lab11/polypoint/pcb/tripoint/v2p0/protopoint.kicad_pcb

## KiCad design pcb/tripoint/v2p0/protopoint.kicad_pcb (2016-08-17)

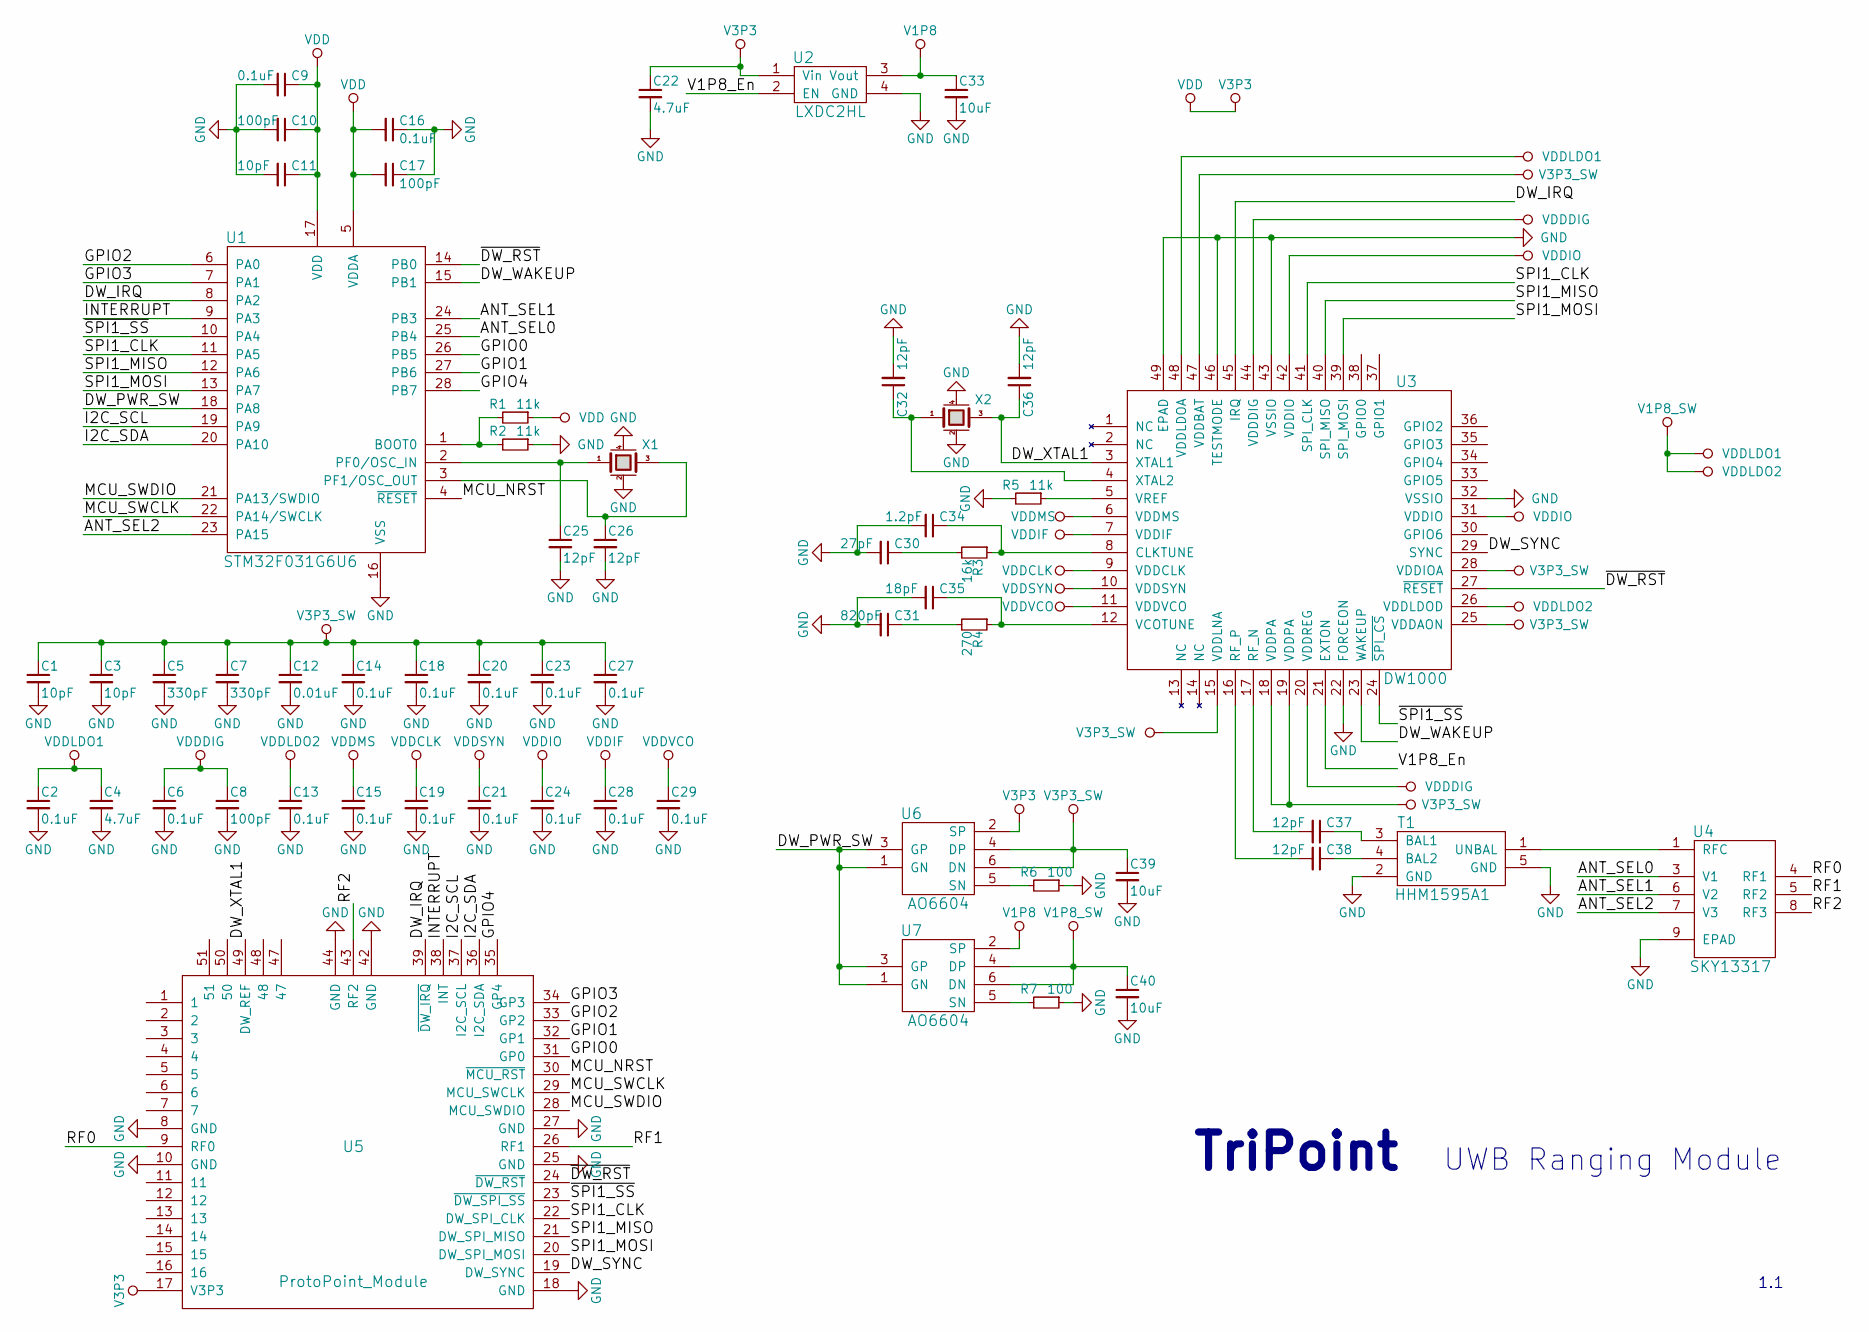
[picture p1: schematic protopoint.sch]

Parts:
C1, C3, C11: 10pF; C_0201; ManPartNo GRM0335C1E100JA01D
C2, C6, C9, C13, C14, C15, C16, C18, C19, C20, C21, C23, C24, C27, C28, C29: 0.1uF; C_0201; ManPartNo GRM033R61A104KE15D
C4, C22: 4.7uF; C_0603; ManPartNo GRM188F51A475ZE20D
C5, C7: 330pF; C_0201; ManPartNo GRM033R71E331KA01D
C8, C10, C17: 100pF; C_0201; ManPartNo GRM0335C1E101JA01D
C12: 0.01uF; C_0201; ManPartNo GRM033R71A103KA01D
C25, C26, C32, C36: 12pF; C_0201; ManPartNo GRM0335C1E120JA01D
C30: 27pF; C_0201; ManPartNo GRM0335C1E270JA01D
C31: 820pF; C_0201; ManPartNo GRM033R71E821KA01D
C33, C39, C40: 10uF; C_0603; ManPartNo GRM188R61C106MA73D
C34: 1.2pF; C_0201; ManPartNo GRM0335C1H1R2CA01D
C35: 18pF; C_0201; ManPartNo GRM0335C1H180JA01D
C37, C38: 12pF; C_0402; ManPartNo GRM1555C1H120JA01D
R1, R2, R5: 11k; R_0201; ManPartNo ERJ-1GEF1102C
R3: 16k; R_0201; ManPartNo ERJ-1GEF1602C
R4: 270; R_0201; ManPartNo ERJ-1GEF2700C
R6, R7: 100; R_0201; ManPartNo ERJ-1GEF1102C
T1: HHM1595A1; ManPartNo HHM1595A1
U1: STM32F031G6U6; UFQFPN-28; ManPartNo STM32F031G6U6
U2: LXDC2HL; ManPartNo LXDC2HL18A-052
U3: DW1000; QFN-48-EP-6x6mm; ManPartNo DW1000-I-TR13
U4: SKY13317; MLPQ-UT-8-1.5X1.5mm; ManPartNo SKY13317-373LF
U5: ProtoPoint_Module; ProtoPoint_Module_Castellated
U6, U7: AO6604; TSOP-6
X1: 38.4M; FA-128; ManPartNo FA-20H 38.4000MF10Z-AS3
X2: 16M; FA-128; ManPartNo FA-20H 16.0000MF10Z-AJ3

Connections:
/ANT_SEL0: U1.25 (PB4), U4.3 (V1)
/ANT_SEL1: U1.24 (PB3), U4.6 (V2)
/ANT_SEL2: U1.23 (PA15), U4.7 (V3)
/DW_IRQ: U1.8 (PA2), U3.45 (IRQ), U5.39 (~DW_IRQ)
/DW_PWR_SW: U1.18 (PA8), U6.1 (GN), U6.3 (GP), U7.1 (GN), U7.3 (GP)
/DW_SYNC: U3.29 (SYNC), U5.19 (DW_SYNC)
/DW_WAKEUP: U1.15 (PB1), U3.23 (WAKEUP)
/DW_XTAL1: C36.1, U3.3 (XTAL1), U5.49 (DW_REF), X2.3
/GPIO0: U1.26 (PB5), U5.31 (GP0)
/GPIO1: U1.27 (PB6), U5.32 (GP1)
/GPIO2: U1.6 (PA0), U5.33 (GP2)
/GPIO3: U1.7 (PA1), U5.34 (GP3)
/GPIO4: U1.28 (PB7), U5.35 (GP4)
/I2C_SCL: U1.19 (PA9), U5.37 (I2C_SCL)
/I2C_SDA: U1.20 (PA10), U5.36 (I2C_SDA)
/INTERRUPT: U1.9 (PA3), U5.38 (INT)
/MCU_NRST: U1.4 (~RESET), U5.30 (~MCU_RST)
/MCU_SWCLK: U1.22 (PA14/SWCLK), U5.29 (MCU_SWCLK)
/MCU_SWDIO: U1.21 (PA13/SWDIO), U5.28 (MCU_SWDIO)
/RF0: U4.4 (RF1), U5.9 (RF0)
/RF1: U4.5 (RF2), U5.26 (RF1)
/RF2: U4.8 (RF3), U5.43 (RF2)
/SPI1_CLK: U1.11 (PA5), U3.41 (SPI_CLK), U5.22 (DW_SPI_CLK)
/SPI1_MISO: U1.12 (PA6), U3.40 (SPI_MISO), U5.21 (DW_SPI_MISO)
/SPI1_MOSI: U1.13 (PA7), U3.39 (SPI_MOSI), U5.20 (DW_SPI_MOSI)
/V1P8_En: U2.2 (EN), U3.21 (EXTON)
/~DW_RST: U1.14 (PB0), U3.27 (~RESET), U5.24 (~DW_RST)
/~SPI1_SS: U1.10 (PA4), U3.24 (~SPI_CS), U5.23 (~DW_SPI_SS)
GND: C1.2, C2.2, C3.2, C4.2, C5.2, C6.2, C7.2, C8.2, C9.2, C10.2, C11.2, C12.2, C13.2, C14.2, C15.2, C16.1, C17.1, C18.2, C19.2, C20.2, C21.2, C22.2, C23.2, C24.2, C25.2, C26.2, C27.2, C28.2, C29.2, C30.2, C31.2, C32.2, C33.2, C34.2, C35.2, C36.2, C39.2, C40.2, R2.1, R5.2, R6.1, R7.1, T1.2 (GND), T1.5 (GND), U1.16 (VSS), U2.4 (GND), U3.22 (FORCEON), U3.32 (VSSIO), U3.43 (VSSIO), U3.46 (TESTMODE), U3.49 (EPAD), U4.9 (EPAD), U5.8 (GND), U5.10 (GND), U5.18 (GND), U5.25 (GND), U5.27 (GND), U5.42 (GND), U5.44 (GND), X1.2 (case), X1.4, X2.2 (case), X2.4
unnamed: C25.1, U1.2 (PF0/OSC_IN), X1.1
unnamed: C26.1, U1.3 (PF1/OSC_OUT), X1.3
unnamed: C30.1, R3.2
unnamed: C31.1, R4.2
unnamed: C32.1, U3.4 (XTAL2), X2.1
unnamed: C34.1, R3.1, U3.8 (CLKTUNE)
unnamed: C35.1, R4.1, U3.12 (VCOTUNE)
unnamed: C37.1, T1.3 (BAL1)
unnamed: C37.2, U3.17 (RF_N)
unnamed: C38.1, T1.4 (BAL2)
unnamed: C38.2, U3.16 (RF_P)
unnamed: R1.2, R2.2, U1.1 (BOOT0)
unnamed: R5.1, U3.5 (VREF)
unnamed: R6.2, U6.5 (SN)
unnamed: R7.2, U7.5 (SN)
unnamed: T1.1 (UNBAL), U4.1 (RFC)
V1P8: C33.1, U2.3 (Vout), U7.2 (SP)
V1P8_SW: C2.1, C4.1, C13.1, C40.1, U3.26 (VDDLDOD), U3.48 (VDDLDOA), U7.4 (DP), U7.6 (DN)
V3P3: C9.1, C10.1, C11.1, C16.2, C17.2, C22.1, R1.1, U1.5 (VDDA), U1.17 (VDD), U2.1 (Vin), U5.17 (V3P3), U6.2 (SP)
V3P3_SW: C1.1, C3.1, C5.1, C7.1, C12.1, C14.1, C18.1, C20.1, C23.1, C27.1, C39.1, U3.15 (VDDLNA), U3.18 (VDDPA), U3.19 (VDDPA), U3.25 (VDDAON), U3.28 (VDDIOA), U3.47 (VDDBAT), U6.4 (DP), U6.6 (DN)
VDDCLK: C19.1, U3.9 (VDDCLK)
VDDDIG: C6.1, C8.1, U3.20 (VDDREG), U3.44 (VDDDIG)
VDDIF: C28.1, U3.7 (VDDIF)
VDDIO: C24.1, U3.31 (VDDIO), U3.42 (VDDIO)
VDDMS: C15.1, U3.6 (VDDMS)
VDDSYN: C21.1, U3.10 (VDDSYN)
VDDVCO: C29.1, U3.11 (VDDVCO)

Notes on the sheet:
TriPoint
1.1
UWB Ranging Module

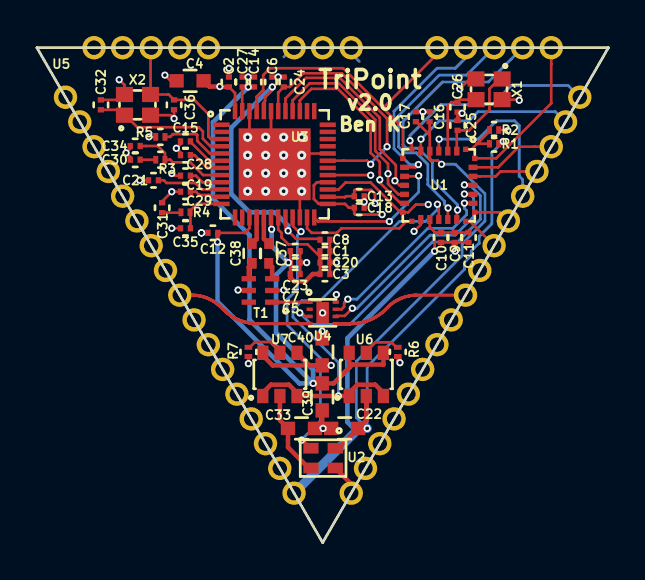
[picture p2: board protopoint.kicad_pcb from above]

Board: 4 copper layers, 31.8 x 27.5 mm, 57 parts (0 on the bottom side), 56 nets.
