lab11/polypoint/pcb/pinpoint/pinpoint_timebase/pinpoint_timebase.kicad_pcb

## KiCad design pcb/pinpoint/pinpoint_timebase/pinpoint_timebase.kicad_pcb (2016-02-21)

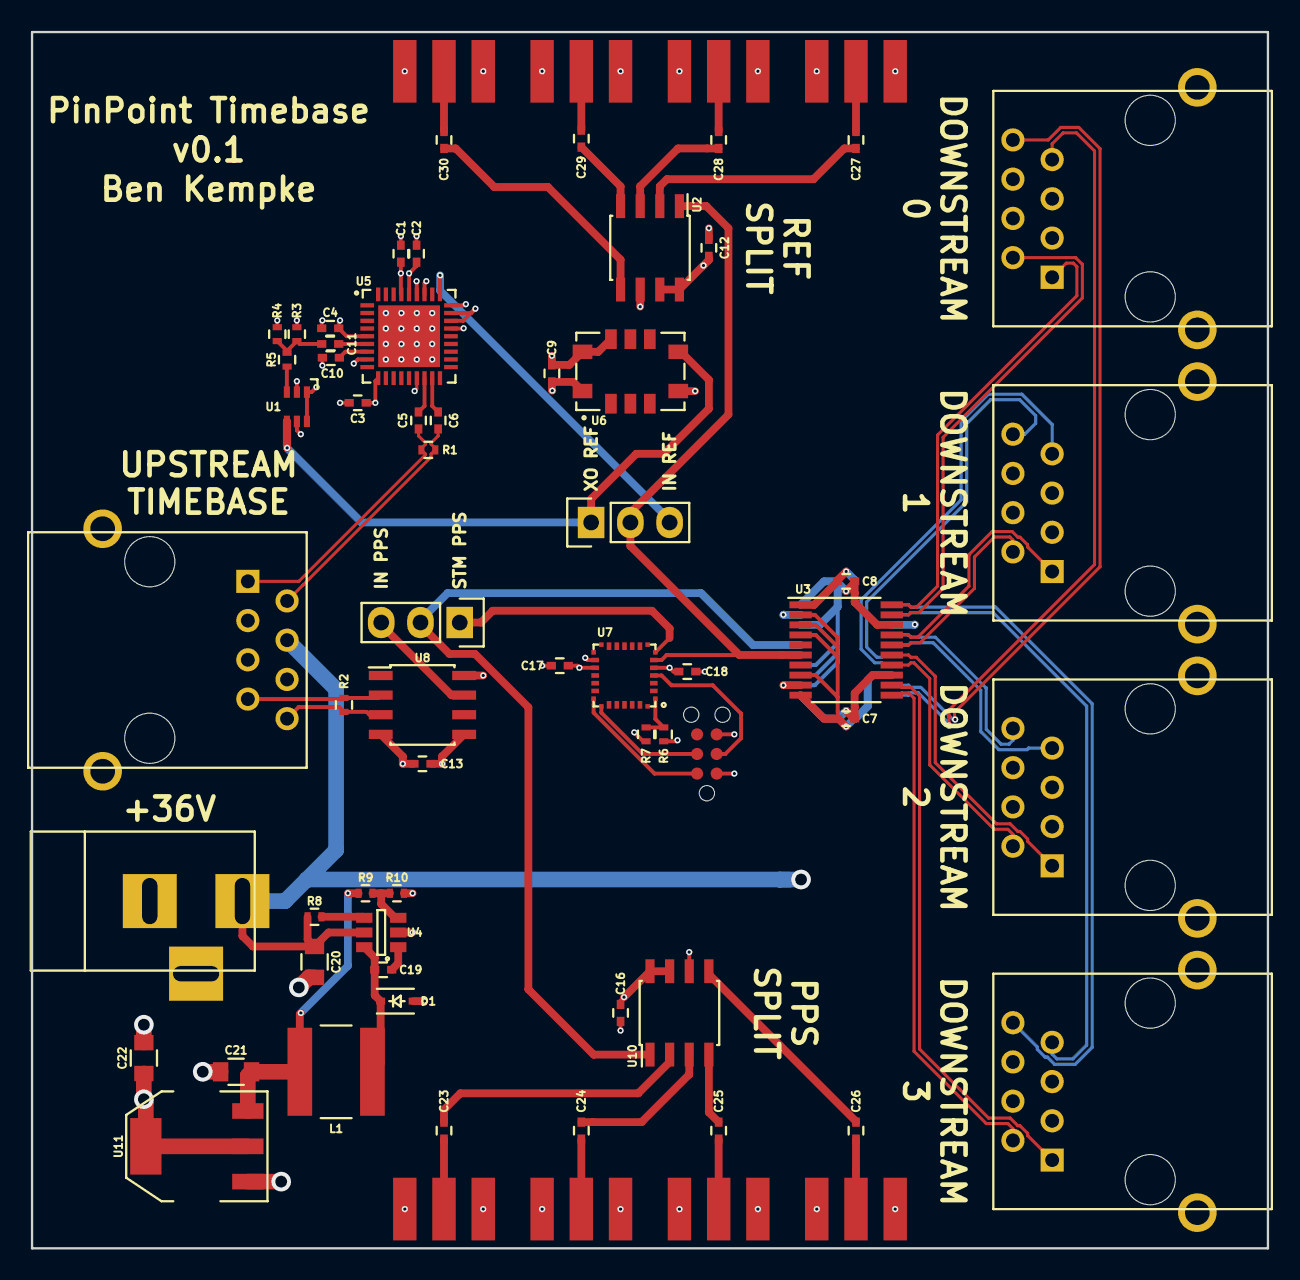
[picture p3: board pinpoint_timebase.kicad_pcb from above]

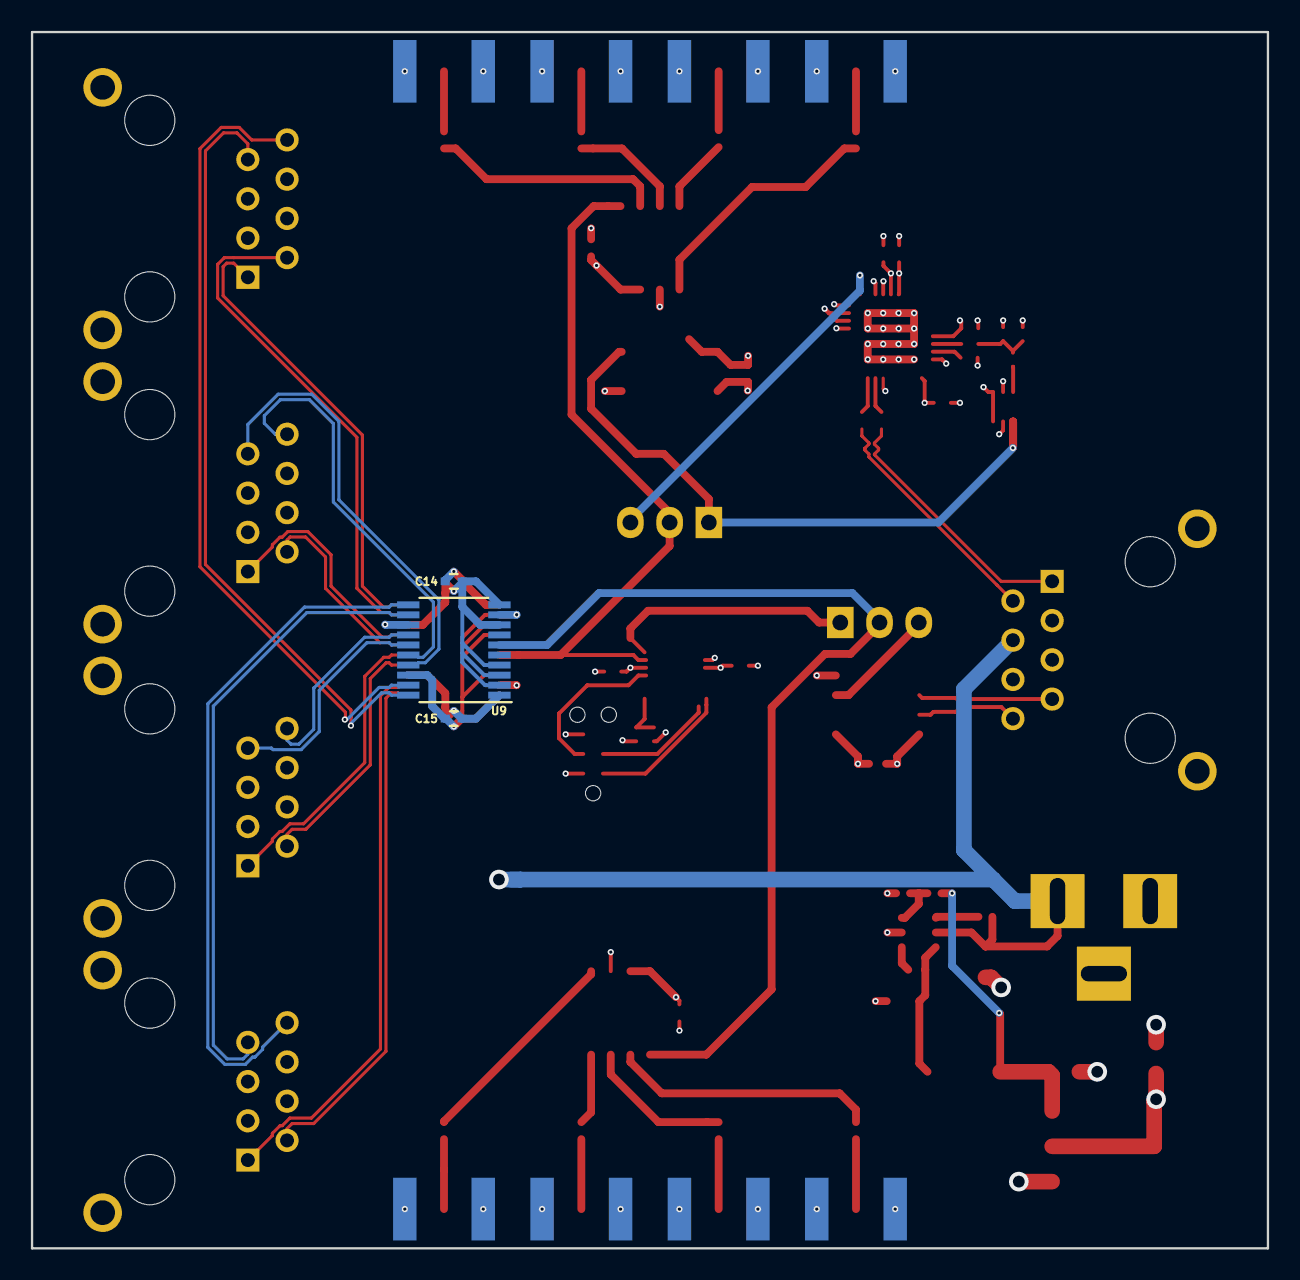
[picture p4: board pinpoint_timebase.kicad_pcb from below]

Board: 4 copper layers, 80.0 x 78.7 mm, 70 parts (3 on the bottom side), 60 nets.

Parts:
C1, C2, C3, C4, C5, C6, C7, C8, C9, C10, C11, C12, C13, C14, C15, C16, C17, C18, C19, C23, C24, C25, C26, C27, C28, C29, C30: 0.1uF; C_0402
C20: 4.7uF; C_0805
C21, C22: 10uF; C_0805
CON1: BARREL_JACK
D1: D_Schottky; SOD-323
J1, J2, J3, J4, J5: RJ45; RJ45_8
J6: TC2030-JLINK-NL; TC2030
L1: 22uH; NR6045
P1, P6: CONN_01X03; Pin_Header_Straight_1x03
P2, P3, P4, P5, P8, P9, P10: SMA; SMA_EDGE
R1, R2, R6, R7: R_Small; R_0402
R3, R4: 150; R_0402
R5: 130; R_0402
R8: 4.7K; R_0402
R9: 49.9K; R_0402
R10: 9.53K; R_0402
U1: SN74AVC1T45; SC-70-6
U2, U10: 551S; SOIC-8_3.9x4.9mm_Pitch1.27mm
U3, U9: ICS8545; TSSOP-20_4.4x6.5mm_Pitch0.65mm
U4: AOZ1282CI; SOT-23-6
U5: SI5317; QFN-36_1EP_6x6mm
U6: 7N-XX.XXXMBP-T; 7N-xx.xxxMBP-T
U7: STM32F031G4U6; UFQFPN-28
U8: 830S21; SOIC-8_3.9x4.9mm_Pitch1.27mm
U11: NCP1117; SOT-223
eP7: SMA; SMA_EDGE

Connections:
/CLK0+: J3.1, U3.20
/CLK0-: J3.2, U3.19
/CLK1+: J4.1, U3.17
/CLK1-: J4.2, U3.16
/CLK2+: J1.1, U3.15
/CLK2-: J1.2, U3.14
/CLK3+: J5.1, U3.12
/CLK3-: J5.2, U3.11
/IN_PPS+: J2.7, R2.1, U8.2
/IN_PPS-: J2.8, R2.2, U8.3
/IN_REF+: C5.2, J2.1, R1.1
/IN_REF-: C6.2, J2.2, R1.2
/PPS0+: J3.7, U9.20
/PPS0-: J3.8, U9.19
/PPS1+: J4.7, U9.17
/PPS1-: J4.8, U9.16
/PPS2+: J1.7, U9.15
/PPS2-: J1.8, U9.14
/PPS3+: J5.7, U9.12
/PPS3-: J5.8, U9.11
/REFTMP+: C5.1, U5.16
/REFTMP-: C6.1, U5.17
/SYS_CLK: P1.2, U2.1, U3.6, U7.6
GND: C1.2, C2.1, C3.2, C4.1, C7.2, C8.1, C9.2, C10.1, C12.2, C13.2, C14.2, C15.1, C16.2, C17.2, C18.1, C20.2, C21.2, C22.2, CON1.2, CON1.3, D1.2, J1.5, J1.9, J2.5, J2.9, J3.5, J3.9, J4.5, J4.9, J5.5, J5.9, J6.5, P2.2, P3.2, P4.2, P5.2, P8.2, P9.2, P10.2, R4.1, R7.2, R10.2, U1.2, U1.5, U2.6, U3.1, U3.9, U3.13, U4.2, U5.8, U5.15, U5.24, U5.27, U5.30, U5.31, U5.37, U6.4, U6.10, U7.16, U8.5, U9.1, U9.9, U9.13, U10.6, U11.1, eP7.2
unnamed: C10.2, U5.7
unnamed: C11.1, R3.1, R4.2, R5.2
unnamed: C11.2, U5.6
unnamed: C19.1, D1.1, L1.1, U4.6
unnamed: C19.2, U4.1
unnamed: C21.1, L1.2, R9.1, U11.3
unnamed: C23.1, U10.2
unnamed: C23.2, eP7.1
unnamed: C24.1, U10.3
unnamed: C24.2, P8.1
unnamed: C25.1, U10.4
unnamed: C25.2, P9.1
unnamed: C26.1, U10.5
unnamed: C26.2, P10.1
unnamed: C27.1, U2.2
unnamed: C27.2, P2.1
unnamed: C28.1, U2.3
unnamed: C28.2, P3.1
unnamed: C29.1, U2.4
unnamed: C29.2, P4.1
unnamed: C30.1, U2.5
unnamed: C30.2, P5.1
unnamed: J6.2, U7.21
unnamed: J6.3, U7.4
unnamed: J6.4, U7.22
unnamed: P1.1, U1.4, U6.5
unnamed: P1.3, U5.28
unnamed: P6.1, U7.7
unnamed: P6.2, U9.6, U10.1
unnamed: P6.3, U8.7
unnamed: R5.1, U1.3
unnamed: R6.1, R7.1, U7.1
unnamed: R8.2, U4.4
unnamed: R9.2, R10.1, U4.3
V3P3: C1.1, C2.2, C3.1, C4.2, C7.1, C8.2, C9.1, C12.1, C13.1, C14.1, C15.2, C16.1, C17.1, C18.2, C22.1, J6.1, R3.2, R6.2, U1.1, U1.6, U2.7, U2.8, U3.2, U3.3, U3.4, U3.8, U3.10, U3.18, U5.5, U5.10, U5.25, U5.26, U5.32, U5.33, U6.8, U6.9, U7.5, U7.17, U8.4, U8.8, U9.2, U9.3, U9.4, U9.8, U9.10, U9.18, U10.7, U10.8, U11.2, U11.4
VDD: C20.1, CON1.1, J1.4, J2.4, J3.4, J4.4, J5.4, R8.1, U4.5
