lab11/polypoint/pcb/pinpoint/pinpoint_tridev_adapter/pinpoint_tridev_adapter.kicad_pcb

## KiCad design pcb/pinpoint/pinpoint_tridev_adapter/pinpoint_tridev_adapter.kicad_pcb (2016-02-21)

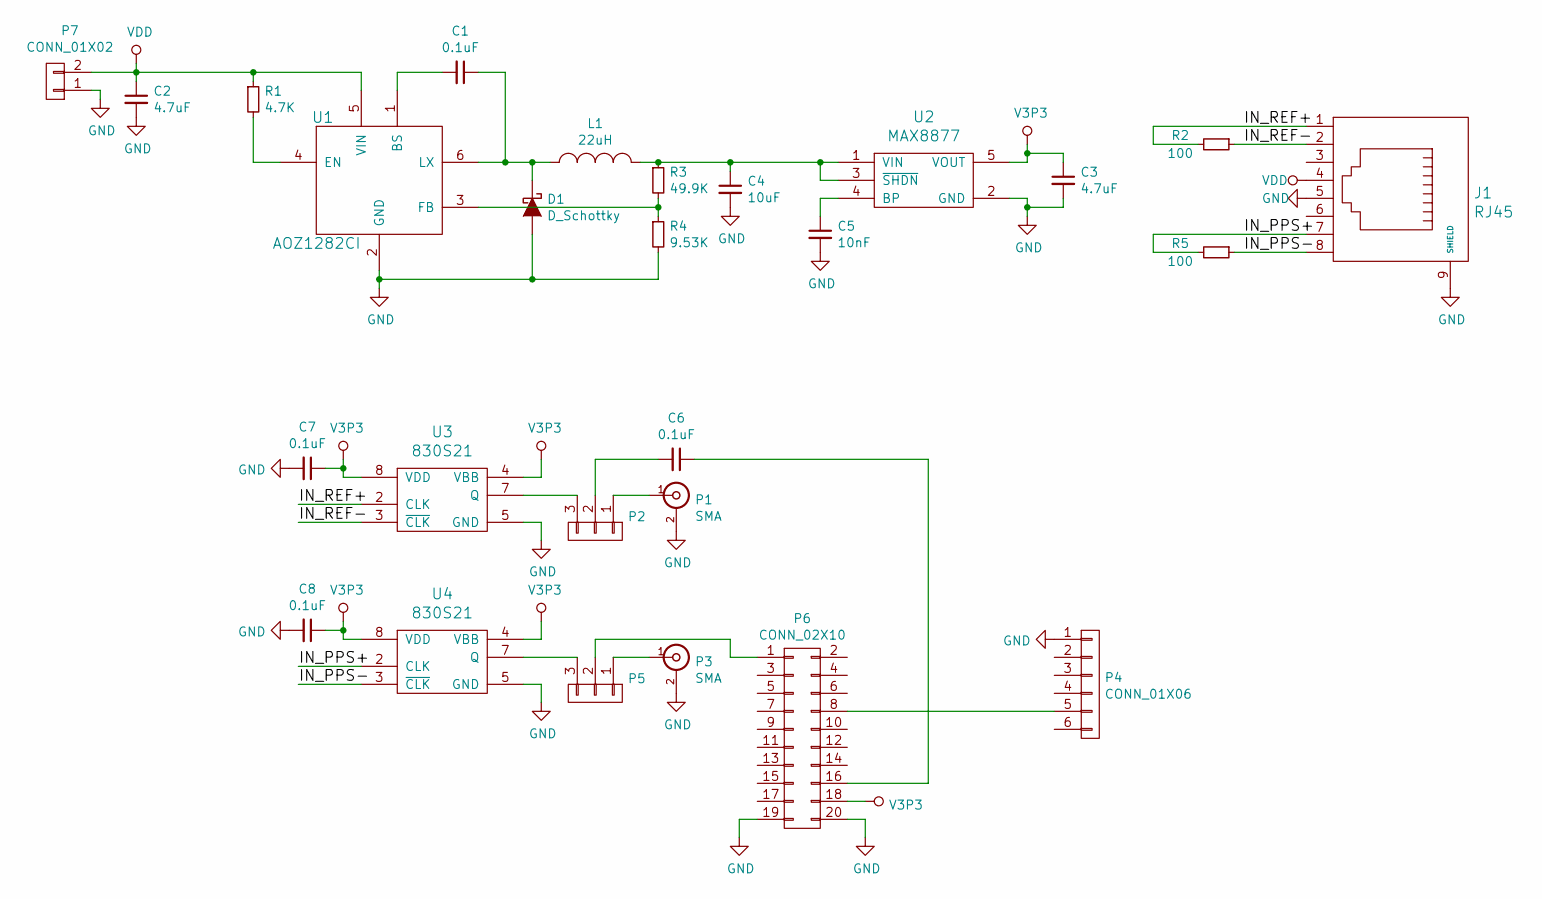
[picture p5: schematic pinpoint_tridev_adapter.sch]

Parts:
C1, C6, C7, C8: 0.1uF; C_0402; ManPartNo GRM155R62A104KE14D
C2, C3: 4.7uF; C_0805; ManPartNo GRM21BR61H475KE51L
C4: 10uF; C_0805; ManPartNo GRM21BR61C106KE15K
C5: 10nF; C_0402; ManPartNo GRM155R71H103KA88D
D1: D_Schottky; SOD-323
J1: RJ45; RJ45_8; ManPartNo A-2004-2-4-LPS-N-R
L1: 22uH; NR6045; ManPartNo NR6045T220M
P1, P3: SMA; SMA_EDGE; ManPartNo CONSMA003.062
P2, P5: CONN_01X03; Pin_Header_Straight_1x03
P4: CONN_01X06; Pin_Header_Straight_1x06
P6: CONN_02X10; Pin_Header_Straight_2x10; ManPartNo SSQ-110-03-T-D
P7: CONN_01X02; Pin_Header_Straight_1x02
R1: 4.7K; R_0402; ManPartNo ERJ-2RKF4701X
R2, R5: 100; R_0402; ManPartNo ERJ-2RKF1000X
R3: 49.9K; R_0402; ManPartNo ERJ-2RKF4992X
R4: 9.53K; R_0402; ManPartNo ERJ-2RKF9531X
U1: AOZ1282CI; SOT-23-6; ManPartNo AOZ1282CI
U2: MAX8877; SOT-23-5; ManPartNo MAX8877EUK33+T
U3, U4: 830S21; SOIC-8_3.9x4.9mm_Pitch1.27mm; ManPartNo 830S21AMI-01LF

Connections:
/IN_PPS+: J1.7, R5.2, U4.2 (CLK)
/IN_PPS-: J1.8, R5.1, U4.3 (~CLK)
/IN_REF+: J1.1, R2.2, U3.2 (CLK)
/IN_REF-: J1.2, R2.1, U3.3 (~CLK)
GND: C2.2, C3.2, C4.2, C5.2, C7.2, C8.2, D1.2 (A), J1.5, J1.9 (SHIELD), P1.2 (Ext), P3.2 (Ext), P4.1, P6.19, P6.20, P7.1, R4.2, U1.2 (GND), U2.2 (GND), U3.5 (GND), U4.5 (GND)
unnamed: C1.1, D1.1 (K), L1.1, U1.6 (LX)
unnamed: C1.2, U1.1 (BS)
unnamed: C4.1, L1.2, R3.1, U2.1 (VIN), U2.3 (~SHDN)
unnamed: C5.1, U2.4 (BP)
unnamed: C6.1, P6.16
unnamed: C6.2, P2.2
unnamed: P1.1 (In), P2.1
unnamed: P2.3, U3.7 (Q)
unnamed: P3.1 (In), P5.1
unnamed: P4.5, P6.8
unnamed: P5.2, P6.1
unnamed: P5.3, U4.7 (Q)
unnamed: R1.2, U1.4 (EN)
unnamed: R3.2, R4.1, U1.3 (FB)
V3P3: C3.1, C7.1, C8.1, P6.18, U2.5 (VOUT), U3.4 (VBB), U3.8 (VDD), U4.4 (VBB), U4.8 (VDD)
VDD: C2.1, J1.4, P7.2, R1.1, U1.5 (VIN)

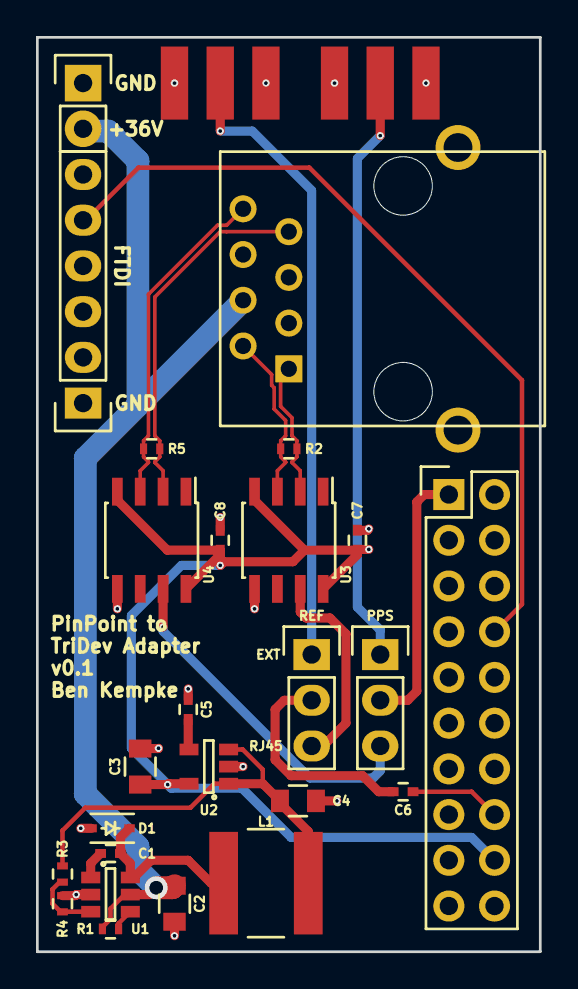
[picture p6: board pinpoint_tridev_adapter.kicad_pcb from above]

Board: 2 copper layers, 27.9 x 50.8 mm, 27 parts (0 on the bottom side), 21 nets.
