lab11/polypoint/pcb/calibration-brace/calibration-brace.kicad_pcb

## KiCad design pcb/calibration-brace/calibration-brace.kicad_pcb (2015-10-21)

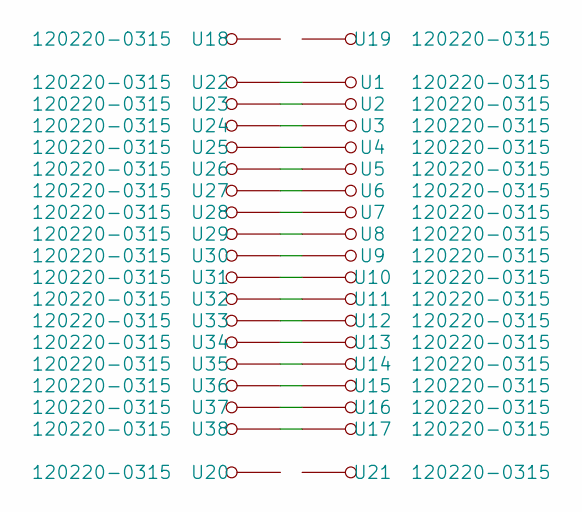
[picture p7: schematic calibration-brace.sch]

Parts:
U1, U2, U3, U4, U5, U6, U7, U8, U9, U10, U11, U12, U13, U14, U15, U16, U17, U18, U19, U20, U21, U22, U23, U24, U25, U26, U27, U28, U29, U30, U31, U32, U33, U34, U35, U36, U37, U38: 120220-0315

Connections:
unnamed: U1.1, U22.1
unnamed: U2.1, U23.1
unnamed: U10.1, U31.1
unnamed: U11.1, U32.1
unnamed: U12.1, U33.1
unnamed: U13.1, U34.1
unnamed: U14.1, U35.1
unnamed: U15.1, U36.1
unnamed: U16.1, U37.1
unnamed: U17.1, U38.1
unnamed: U3.1, U24.1
unnamed: U4.1, U25.1
unnamed: U5.1, U26.1
unnamed: U6.1, U27.1
unnamed: U7.1, U28.1
unnamed: U8.1, U29.1
unnamed: U9.1, U30.1

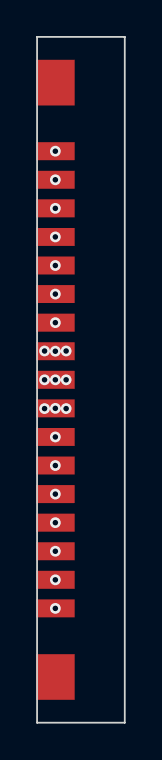
[picture p8: board calibration-brace.kicad_pcb from above]

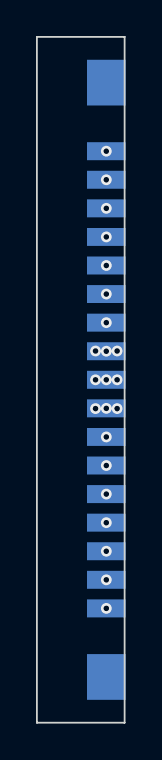
[picture p9: board calibration-brace.kicad_pcb from below]

Board: 2 copper layers, 4.9 x 38.1 mm, 38 parts (19 on the bottom side), 17 nets.
