lab11/polypoint/pcb/dwatum/dwatum.kicad_pcb

## KiCad design pcb/dwatum/dwatum.kicad_pcb (2015-05-05)

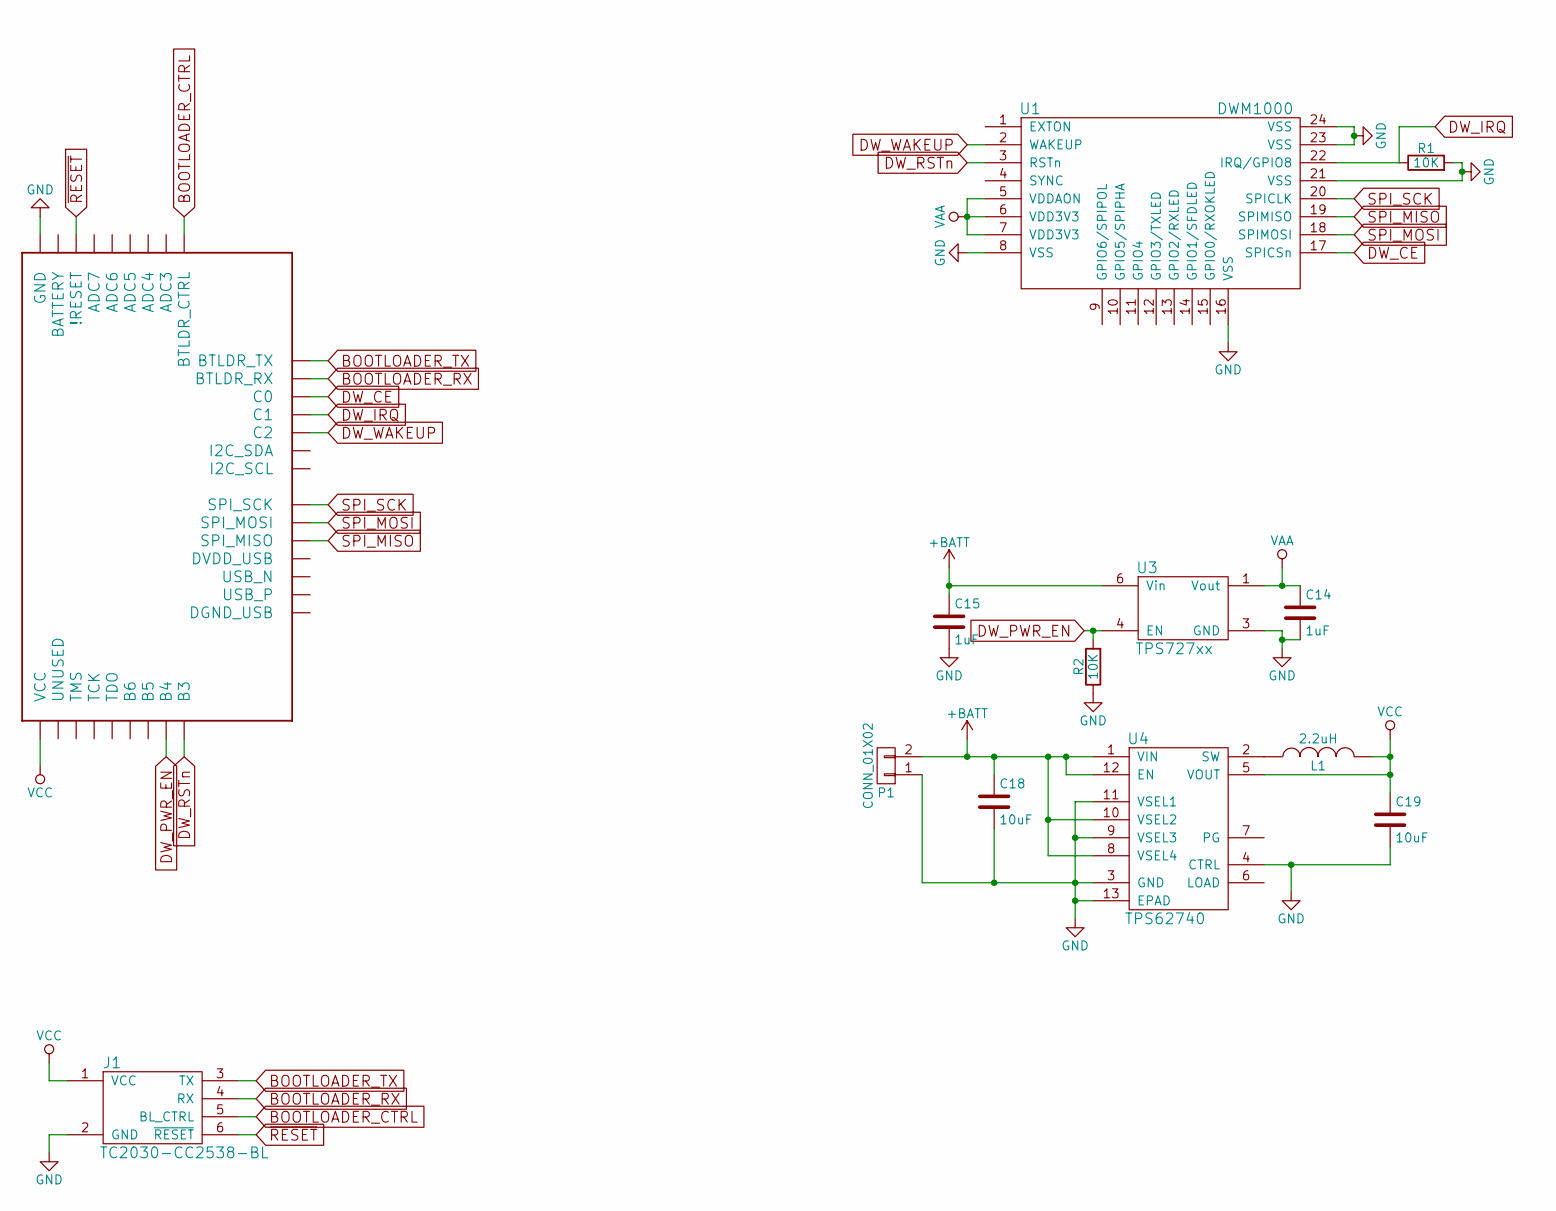
[picture p12: schematic dwatum.sch]

Parts:
C14, C15: 1uF; C_0402
C18, C19: 10uF; C_0603
J1: TC2030-CC2538-BL; TC2030
L1: 2.2uH; MIPSZ201D
P1: CONN_01X02; Pin_Header_Straight_1x02
R1, R2: 10K; R_0402
U1: DWM1000; DWM1000_REVERSE_SMD
U2: ATUM; ATUM_SMD
U3: TPS727xx; WSON-8_1.5x1.5mm
U4: TPS62740; R-PWSON-12

Connections:
+BATT: C15.1, C18.1, P1.2, U3.6 (Vin), U4.1 (VIN), U4.8 (VSEL4), U4.10 (VSEL2), U4.12 (EN)
BOOTLOADER_CTRL: J1.5 (BL_CTRL), U2.24 (BTLDR_CTRL)
BOOTLOADER_RX: J1.4 (RX), U2.22 (BTLDR_RX)
BOOTLOADER_TX: J1.3 (TX), U2.23 (BTLDR_TX)
DW_CE: U1.17 (SPICSn), U2.21 (C0)
DW_IRQ: R1.1, U1.22 (IRQ/GPIO8), U2.20 (C1)
DW_PWR_EN: R2.2, U2.8 (B4), U3.4 (EN)
DW_RSTn: U1.3 (RSTn), U2.9 (B3)
DW_WAKEUP: U1.2 (WAKEUP), U2.19 (C2)
GND: C14.2, C15.2, C18.2, C19.2, J1.2 (GND), P1.1, R1.2, R2.1, U1.8 (VSS), U1.16 (VSS), U1.21 (VSS), U1.23 (VSS), U1.24 (VSS), U2.32 (GND), U3.3 (GND), U4.3 (GND), U4.4 (CTRL), U4.9 (VSEL3), U4.11 (VSEL1), U4.13 (EPAD)
unnamed: L1.1, U4.2 (SW)
SPI_MISO: U1.19 (SPIMISO), U2.14 (SPI_MISO)
SPI_MOSI: U1.18 (SPIMOSI), U2.15 (SPI_MOSI)
SPI_SCK: U1.20 (SPICLK), U2.16 (SPI_SCK)
VAA: C14.1, U1.5 (VDDAON), U1.6 (VDD3V3), U1.7 (VDD3V3), U3.1 (Vout)
VCC: C19.1, J1.1 (VCC), L1.2, U2.1 (VCC), U4.5 (VOUT)
~RESET: J1.6 (~RESET), U2.30 (!RESET)

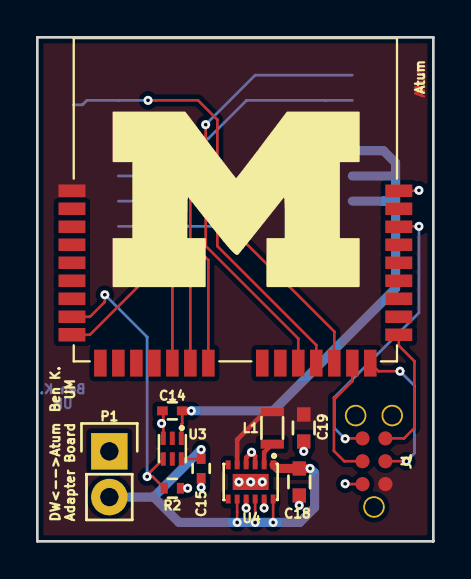
[picture p13: board dwatum.kicad_pcb from above]

Board: 2 copper layers, 22.0 x 28.0 mm, 13 parts (1 on the bottom side), 17 nets.
